senrobo/2023misc/graphics/layerlabels/Layer 1 Label.png

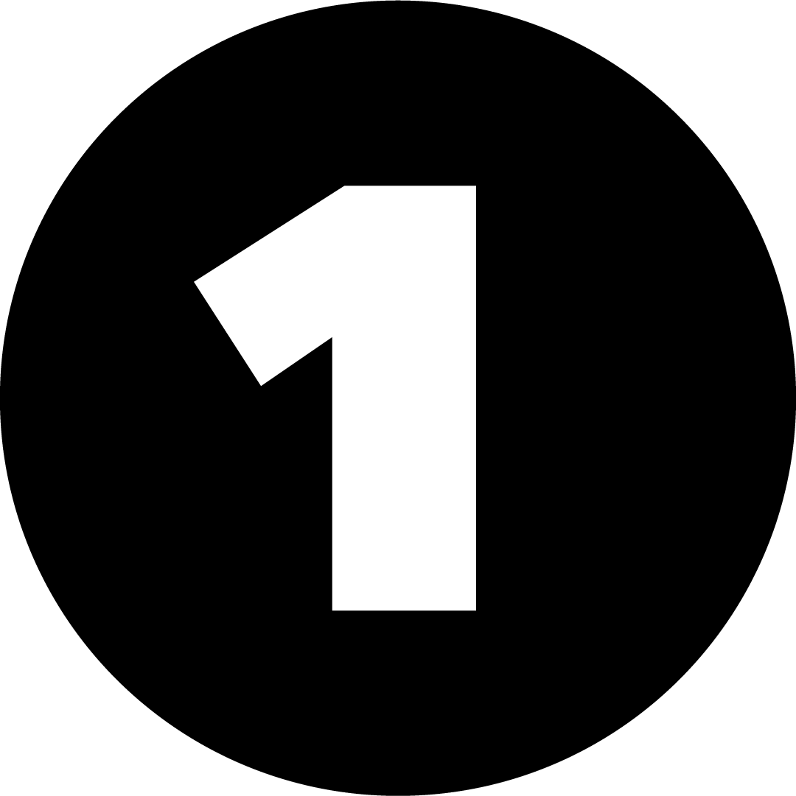
graphics/layerlabels/Layer 1 Label.png
