senrobo/2023misc/graphics/layerlabels/Layer 1.5 Label.png

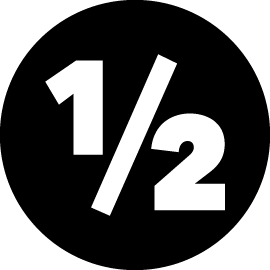
graphics/layerlabels/Layer 1.5 Label.png
