senrobo/2023misc/graphics/layerlabels/Layer 2 Label.png

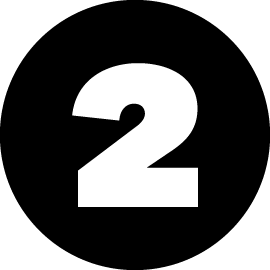
graphics/layerlabels/Layer 2 Label.png
