senrobo/2023misc/graphics/layerlabels/Layer 3 Label.png

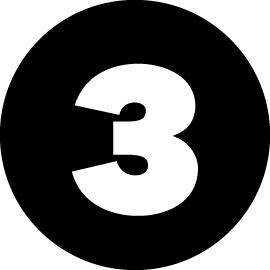
graphics/layerlabels/Layer 3 Label.png
