senrobo/2023misc/graphics/pcbassets/battery/batterydecal.png

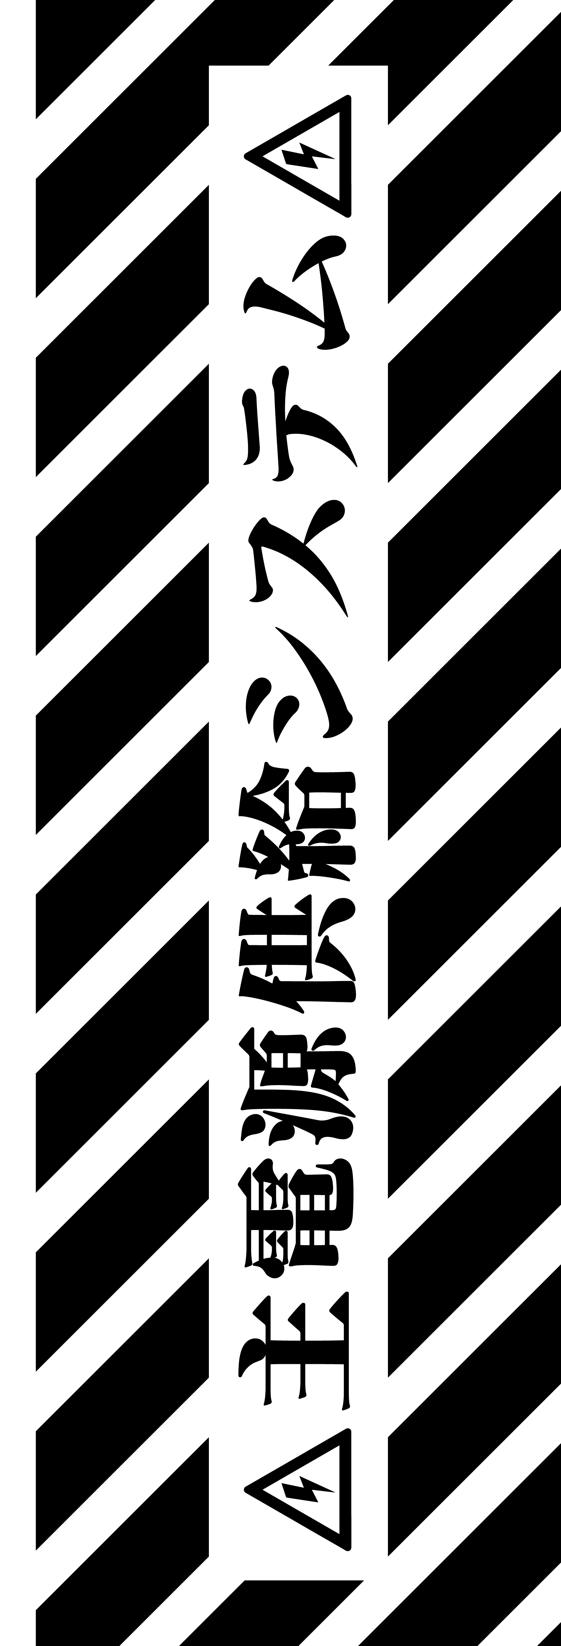
graphics/pcbassets/battery/batterydecal.png
