senrobo/2023misc/.stl/Chihai Motor Mount/chihai mount_bottom v2.stl

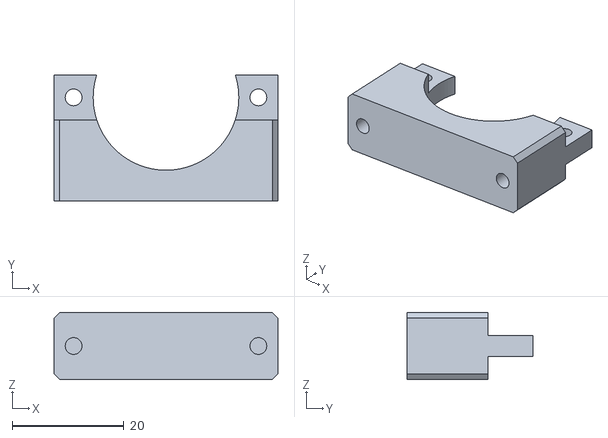
[picture p6: CAD file, 2022-06-28]
.stl/Chihai Motor Mount/chihai mount_bottom v2.stl
40.0 x 22.5 x 12.0
