senrobo/2023misc/graphics/sen/.dxf/sen_white spline.dxf

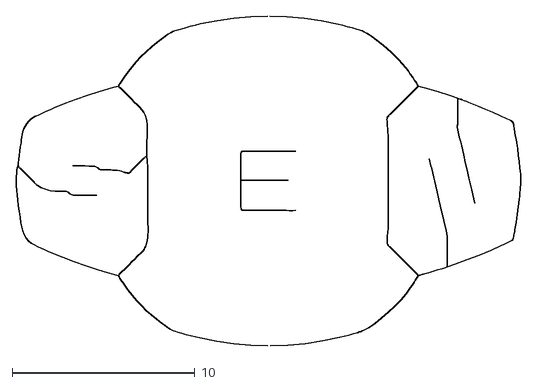
[picture p7: CAD file, 2022-05-29]
graphics/sen/.dxf/sen_white spline.dxf
27.6 x 18.0
