senrobo/2023misc/graphics/sen/.dxf/sen_white.dxf

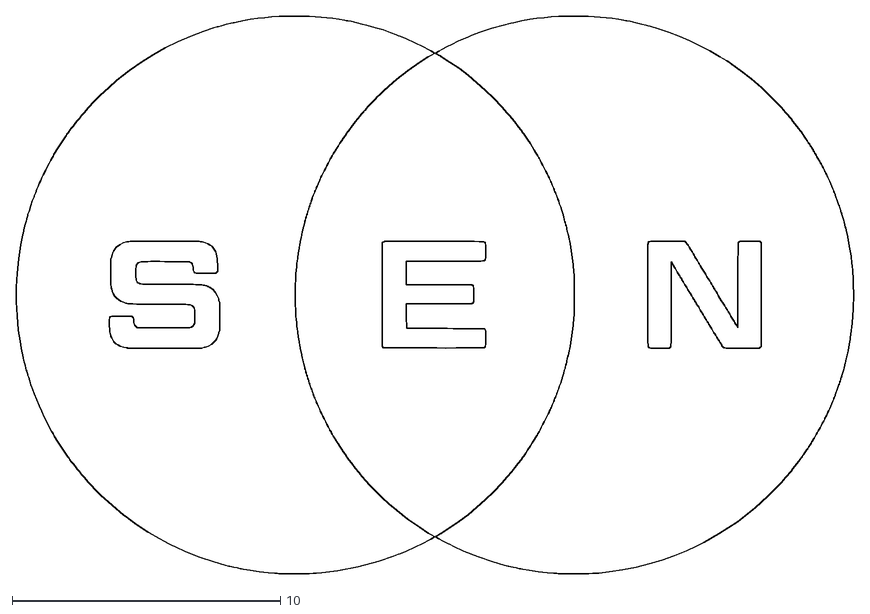
[picture p9: CAD file, 2022-05-29]
graphics/sen/.dxf/sen_white.dxf
31.2 x 20.8
