senrobo/2023misc/.stl/Chihai Motor Mount/chihai mount_left_peg v1.stl

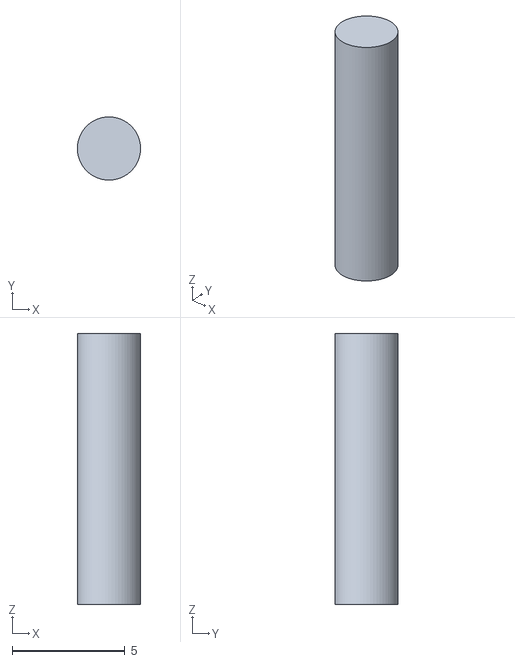
[picture p10: CAD file, 2022-06-28]
.stl/Chihai Motor Mount/chihai mount_left_peg v1.stl
2.80 x 2.80 x 12.0
