senrobo/2023misc/(list of files, cad)

Other CAD files:
graphics/sen/.dwg/sen_vert.dwg
graphics/old/sen-old/.dwg/sen_vert.dwg
graphics/old/sen-old/.dwg/sen_white.dwg
graphics/sen/.dwg/sen_white.dwg
