senrobo/2023misc/logbook/2023-2-16.md

# February 16th 2023

 Wow serial connection between teensy and STM32 works yay

 The NOT Gate not connected properly crying 
-- Signing Off Vincent Cayadi
