senrobo/2023misc/code/Cleaned up code (w explanation)/cleaned_up_code/Light.ino

void readlight1()  { 
//top
  digitalWrite(s0, LOW);
  digitalWrite(s1, LOW);
  digitalWrite(s2, LOW);
  digitalWrite(s3, LOW);
  lightVals[0]=analogRead(SIG_1);
  digitalWrite(s0, HIGH);
  digitalWrite(s1, LOW);
  digitalWrite(s2, LOW);
  digitalWrite(s3, LOW);
  lightVals[1]=analogRead(SIG_1);
  digitalWrite(s0, LOW);
  digitalWrite(s1, HIGH);
  digitalWrite(s2, LOW);
  digitalWrite(s3, LOW);
  lightVals[2]=analogRead(SIG_1);
  digitalWrite(s0, HIGH);
  digitalWrite(s1, HIGH);
  digitalWrite(s2, LOW);
  digitalWrite(s3, LOW);
  lightVals[3]=analogRead(SIG_1);
  digitalWrite(s0, LOW);
  digitalWrite(s1, LOW);
  digitalWrite(s2, HIGH);
  digitalWrite(s3, LOW);
  lightVals[4]=analogRead(SIG_1);
  digitalWrite(s0, HIGH);
  digitalWrite(s1, LOW);
  digitalWrite(s2, HIGH);
  digitalWrite(s3, LOW);
  lightVals[5]=analogRead(SIG_1);
  digitalWrite(s0, LOW);
  digitalWrite(s1, HIGH);
  digitalWrite(s2, HIGH);
  digitalWrite(s3, LOW);
  lightVals[6]=analogRead(SIG_1);
//bot  
  digitalWrite(s0, HIGH);
  digitalWrite(s1, HIGH);
  digitalWrite(s2, HIGH);
  digitalWrite(s3, LOW);
  lightVals[7]=analogRead(SIG_1);
  digitalWrite(s0, LOW);
  digitalWrite(s1, LOW);
  digitalWrite(s2, LOW);
  digitalWrite(s3, HIGH);
  lightVals[8]=analogRead(SIG_1);
  digitalWrite(s0, HIGH);
  digitalWrite(s1, LOW);
  digitalWrite(s2, LOW);
  digitalWrite(s3, HIGH);
  lightVals[9]=analogRead(SIG_1);
  digitalWrite(s0, LOW);
  digitalWrite(s1, HIGH);
  digitalWrite(s2, LOW);
  digitalWrite(s3, HIGH);
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
}
int processlight() { //0=in, 8=bot, 15=right, 1=top, 22=left; returns the first sensor it detects out
  for(int i=0; i<7;i++) {
    if(lightVals[i]>lightThresh[i]) {
    topOut++; 
    }
  }
  for(int i=0;i<28;i++) {
    if(lightVals[i]>lightThresh[i]) {
      return i+1;
    }
  }
  return 0;

    /*for(int i=7;i<14;i++) {
      if(lightVals[i]>lightThresh[i]) botOut++;
  }
    for(int i=21; i<28;i++) {
      if(lightVals[i]>lightThresh[i]) leftOut++;
  }
    for(int i=14; i<21;i++) {
      if(lightVals[i]>lightThresh[i]) rightOut++;
    }*/
}

void caughtball() {
  lightgateVal = analogRead(A9);
  if(lightgateVal<52)  ballcatch = 1;
  else ballcatch = 0;
  Serial.println(ballcatch);
}


void resetlight() {
  topOut=0;
}


void calibrate_light(){
  int diff;
  int vals[28];
  //Serial.print("max: ");
  for (int i=0;i<28;i++){
    if (lightVals[i]>maxVals[i]) maxVals[i]=lightVals[i];

    if (lightVals[i]<minVals[i]) minVals[i]=lightVals[i];
   // diff=maxVals[i]-minVals[i];
  }
  for (int i=0;i<28;i++){
    vals[i]=round(((maxVals[i]+minVals[i])/2));
    Serial.print(vals[i]);
    Serial.print(',');
  }
  Serial.println();
}
