senrobo/2023misc/(commit log)

2022-05-29 git ignore and directories
    [sen_vert.dwg, sen_white spline.dxf, sen_white.dwg, sen_white.dxf]
2022-06-04 wheel dwg model and dxf layer sketches
    [Lightweight_Wheel.dwg, wheellayer1.dxf, wheellayer2.dxf, wheellayer3.dxf, wheellayer4.dxf]
2022-06-04 edited wheel models
    [Lightweight_Wheel.dwg]
2022-06-28 stl files for chihai mount and cura profile
    [chihai mount_bottom v2.stl, chihai mount_left_peg v1.stl, chihai mount_top v2.stl]
2022-07-06 stl export batch
    [L1_Sketchv1.dxf, L1_Sketchv2.dxf, L2_Sketchv1.dxf, L2_Sketchv2.dxf, L3_Sketchv1.dxf, backBatteryBlockerv1.stl, chihai mount_bottomv2.stl, chihai mount_bottomv9.stl]
2022-07-17 Added alot of dxf files
    [L2_Sketchv3.dxf, L2_Sketchv4.dxf, L2_Sketchv5.dxf, L2_Sketchv6.dxf, L2_Sketchv7.dxf, L3_Sketchv2.dxf, L3_Sketchv3.dxf, L3_Sketchv4.dxf]
2022-08-01 done with US code
    [L2_Sketchv10.dxf, L2_Sketchv8.dxf, L2_Sketchv9.dxf]
2022-09-15 added dxf
    [L1.5_Sketchv1.dxf, L1.5_Sketchv2.dxf, L1.5_Sketchv3.dxf, L1.5_Sketchv4.dxf, L1.5_Sketchv5.dxf, L3_Sketchv8.dxf, L3_Sketchv9.dxf]
2022-09-16 gerber file
2022-09-16 gerber file layer 2 v3
2022-09-16 gerber files and some png and svg exports for new logo
2022-09-20 Added taobao
    [L2_Sketchv11.dxf, L3_Sketchv10.dxf, L3_Sketchv11.dxf, taobao.xlsx]
2022-11-12 Added initIR and readIR
    [taobao.xlsx]
2022-12-31 added battery decal graphic and modified folder structure for graphics
    [sen_vert.dwg, sen_white spline.dxf, sen_white.dwg, sen_white.dxf]
2023-01-11 copied from senior code lmao
    [L1.5_Sketchv1.dxf, L1.5_Sketchv2.dxf, L1.5_Sketchv3.dxf, L1.5_Sketchv4.dxf, L1.5_Sketchv5.dxf, L1.5_Sketchv6.dxf, L1.5_Sketchv7.dxf, L1.5_Sketchv7_(offset2mm-centered).dxf]
2023-01-26 cleaned up
    [L1.5_Sketchv1.dxf, L1.5_Sketchv2.dxf, L1.5_Sketchv3.dxf, L1.5_Sketchv4.dxf, L1.5_Sketchv5.dxf, L1.5_Sketchv6.dxf, L1.5_Sketchv7.dxf, L1.5_Sketchv7_(offset2mm-centered).dxf]
2023-02-14 serial communication between teensy and cam works
2023-02-16 i fixed one issue
    [main.cpp]
2023-03-08 copied Read Light Sensors from Greg
